fra589/WeTimer/readme.md

# Minuterie pour planeur de vol libre
<!--<img align="left" width="80" height="80" src="https://github.com/fra589/WeTimer/blob/master/doc/images/WeTimer_logo.svg">-->
<p>


Basée sur une carte microcontrôleur WiFi ESP8266 de type Wemos D1 mini (34mm x 26mm), disponible pour quelques euros, la minuterie WeTimer permet de commander deux servos en fonction des différentes phases de vol du planeur.

L’un des servo permet de commander les mouvement du stabilisateur avec une position pendant la phase de treuillage, une position pendant la phase de vol et une dernière position lors du déthermalisage. L’autre servo permet 2 positions de dérive, l’une pendant le treuillage lorsque le câble est tendu (dérive dans l’axe), l’autre pendant le vol ou lorsque le câble est détendu.<br />
Le temps de vol débute suite à une action sur un switch actionné par la tension ou le largage du câble de treuillage.

La configuration se fait au travers d'un interface web accessible via smartphone avec une connexion WiFi.<br />
Cette connexion WiFi permet égalament d'activer la fonctionalité de déthermalisation à distance (RDT) avec une portée d'une (a quelques) centaine(s) de mètres.

<!--<p align="center">
<img src="../master/doc/images/WeTimer_proto01_recto.jpg" width="36%" height="36%"> <img src="../master/doc/images/WeTimer_proto01_verso.jpg" width="36%" height="36%"> <img src="../master/doc/images/WeTimer_proto01_servo.jpg" width="20.3%" height="20.3%">
</p>-->
</p>
<br />
<hr />

La notice d'utilisation de cette minuterie (version 1 (zoom)) est ici : [Notice WeTimer.pdf](https://github.com/fra589/WeTimer/blob/master/documentation/doc%20version%201/Notice%20WeTimer_v1.pdf)<br />
La documentation d'installation logiciel et de programation de la carte microcontroleur est ici : [Installation WeTimer.pdf](https://github.com/fra589/WeTimer/blob/master/documentation/doc%20version%201/Installation%20WeTimer.pdf)
<br />
<br />
La notice de la version 2 est ici : [Manuel utilisateur WeTimer v2.pdf](https://github.com/fra589/WeTimer/blob/master/documentation/doc%20version%202/Manuel%20utilisateur%20WeTimer%20v2.pdf)<br />
<br />
<br />

<p align="center"><font size="3">Bons vols avec WeTimer !</font></p>

<br />
<br />
