fra589/WeTimer/(commit log)

2021-08-03 Fixing 2 little errors/warning fix "conversion from 'const __FlashStringHelper*' to 'const StringSumHelper' is ambiguous" fix "warning: 'BUILTIN_LED' is deprecated"
    [WeTimer.ino]
2021-09-18 Ajout servo de dérive et position treuil du servo de stabilisateur.
2021-09-22 suite de la doc
2021-09-23 Mise à jour de la documentation
2021-09-29 Hauteur dynamique zones de saisies
2023-01-17 Ajout d'un lien vers la notice
2023-01-17 Ajout images d'un prototype
2023-01-29 Mise à jour documentation Correction lien symbolique pdf principal qui ne fonctionne pas sur Github Ajout des fichiers sources LibreOffice
2023-03-28 Ajout installation driver Windows dans doc d'installation
2023-03-29 Correction bug parametres virages treui & treuil tenu
    [WeTimer.h]
2025-01-23 correction insecte numerotation servos
    [WeTimer.h, scripts.js, webserver.cpp]
2025-01-24 Ajout schema alimentation switch hall
2025-01-24 correction insecte servopos
2025-08-21 Ajout schéma clablage LiPo 2S
